roitsch-code/bedroom-air-monitor/firmware/trmnl-display/config.example.h

// Copy this file to config.h and fill in your values. config.h is git-ignored.
#pragma once

// ── Wi-Fi ────────────────────────────────────────────────────────────────────
#define WIFI_SSID   "your-network"
#define WIFI_PASS   "your-password"

// ── Where to fetch the reading from ──────────────────────────────────────────
// The sensor node's /now endpoint. Use the sensor's FIXED IP.
#define SENSOR_URL  "http://192.168.1.50/now"

// ── Outdoor temperature (Open-Meteo, no key needed) ─────────────────────────
// Your rough coordinates — this is only used for the outdoor reading, nothing else.
#define WEATHER_LAT  "51.2277"
#define WEATHER_LON  "6.7735"

// ── Refresh cadence ──────────────────────────────────────────────────────────
// How long between redraws. Every wake costs a Wi-Fi connect + a full e-ink flash, so don't go
// too low — 10–15 minutes is plenty for air.
#define REFRESH_MINUTES  12

// ── Airing verdict — PLACEHOLDER thresholds ──────────────────────────────────
// Markus is designing the real decision (CO₂ + VOC + indoor/outdoor temp + humidity together)
// himself — this is only a stand-in so the display shows something sensible until that's ready.
// Swap the numbers here, or replace decideAiring() in the .ino once the real rules exist.
#define CO2_AIR_PPM      1400   // at/above this: window should go, full stop
#define CO2_SOFT_PPM     1000   // between SOFT and AIR: worth a quick airing
#define VOC_AIR          250    // Sensirion VOC index (~100 = normal air): treated as seriously as high CO₂
#define VOC_SOFT         150    // between SOFT and AIR: worth a quick airing, same as CO₂_SOFT
#define HUMIDITY_HIGH    60     // %RH at/above this: airing hint mentions it regardless of CO₂/VOC
// How much drier outside must be than inside, in ABSOLUTE humidity (grams of water per m³ — NOT
// %RH), before airing is actually recommended for humidity. Absolute humidity is what physically
// matters: warm air holds far more water than cold air, so "90% outside" at 3°C can hold LESS real
// water than "60% inside" at 22°C — comparing %RH directly gets that backwards. Without this: a
// rainy mild day (outdoor RH ~100%, similar temp to indoors) would wrongly say "air it out" and
// make the room damper; a cold winter day (outdoor RH also ~90%, but freezing) would wrongly say
// "don't bother" even though that cold air is exactly what would dry the room out.
#define HUMIDITY_MARGIN_ABS  1.5   // g/m³ outside must be below inside
// Below this outdoor temperature, an airing recommendation is phrased as a short burst
// (Stoßlüften) rather than leaving the window open — cold air drops the room's temperature fast.
#define COLD_OUTSIDE_C   5
