roitsch-code/bedroom-air-monitor/(commit log)

2026-08-24 Seed the project: two firmwares, wiring, and a README worth reading
    The sensor node (QT Py ESP32-S2) reads the SCD-41 and SEN54 over one solderless
    I2C chain, serves the current reading as JSON on the LAN, and optionally logs it.
    The SCD-41 runs continuously because it is silent; the SEN54's fan only spins up
    in short bursts so it does not hum next to where you sleep.
    The display node (TRMNL / XIAO ESP32-S3) fetches that JSON on an interval, draws
    CO2, temperature, humidity and a plain airing hint, and deep-sleeps between. No
    TRMNL cloud, no third-party server — the two devices talk straight to each other.
    Honest about what is not yet proven: the firmware follows the named libraries'
    doc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
    [config.example.h, qtpy-sensor.ino, trmnl-display.ino]
2026-08-25 Wiring: spell out the SCD-41's two ports and the SEN54's 6-pin JST-GH cable
    Verified against Adafruit's adapter docs — the SEN54 connects with the 6-pin
    JST-GH cable it ships with, not a STEMMA QT. Noted the keyed connectors and to
    plug USB in last.
    Claude-Session: https://claude.ai/code/session_01WurZF8924VeSZfsHVJGuCe
2026-08-25 Flag the missing cable: SEN54 to adapter needs a JST-GH plug-to-plug, not included
    Neither the adapter nor the SEN54's own cable gives you a usable sensor-to-adapter
    link — the adapter ships bare and the SEN54's cable has bare pins on one end. You
    need a 6-pin JST-GH plug-to-plug cable (e.g. Adafruit 5754), ordered separately.
    The CO2 sensor needs none of this and can be built first.
    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
2026-08-25 Fix Sensirion API: match the current library naming and methods
    The sketch was written against the old Sensirion library API. The libraries in
    the Library Manager now use SensirionI2cScd4x.h (lowercase c) with begin(Wire,
    SCD41_I2C_ADDR_62), setAutomaticSelfCalibrationEnabled and getDataReadyStatus,
    while the SEN5x lib keeps SensirionI2CSen5x.h (uppercase). Compilation failed on
    the first missing header; corrected all four names and the three renamed calls.
    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
    [qtpy-sensor.ino]
2026-08-25 Use Wire1 for the sensors: the QT Py ESP32-S2 STEMMA QT port is not Wire
    Confirmed on real hardware: the sensor powered up (green LED) but never answered
    on I2C, because the code talked on Wire (the castellated side pads) while the
    STEMMA QT connector — where the sensor actually plugs in — is Wire1 (SDA1/SCL1)
    on this board. Set the pins explicitly and begin Wire1. Also added the 500 ms
    the SCD4x needs after stopPeriodicMeasurement before it will start, without
    which the CO2 reading never becomes ready.
    Verified live: CO2 reads ~540 ppm at rest and jumps past 1400 on a breath.
    Claude-Session: https://claude.ai/code/session_01WurZF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
2026-08-26 Fix firmware to match Seeed's actual Seeed_GFX library
    Verified against the library source and Seeed's own wiki
    (wiki.seeedstudio.com/ogdiy_kit_works_with_arduino): the real header
    is TFT_eSPI.h (Seeed_GFX is a TFT_eSPI fork that kept the name), and
    driver.h needs BOTH BOARD_SCREEN_COMBO 502 AND
    USE_XIAO_EPAPER_DISPLAY_BOARD_EE04 (the second one selects the pin
    map for this exact carrier board, confirmed against
    EPaper_Board_Pins_Setups.h) -- my first pass had the wrong include
    name and had dropped the second define.
    [driver.h, trmnl-display.ino]
2026-08-26 Fix: move Verdict struct above Reading's function block
    Arduino auto-generates function prototypes near the top of the file;
    a prototype returning Verdict before the struct was defined further
    down failed with 'Verdict does not name a type'.
    [trmnl-display.ino]
2026-08-27 Add first rough enclosure concept (OpenSCAD)
    Three-bay case: QT Py (USB-C exit), SCD-41 (5 vent slots), SEN54
    module (7 vent slots + side fan hole) -- verified against Adafruit's
    and Sensirion's own published dimensions. Rendered and STL-exported
    locally to catch two real bugs before handing it over: a 2D/3D module
    mixup that dropped the walls entirely, and screw bosses that were
    getting deleted by the interior cavity cut.
    [sensor-case.scad]
2026-08-27 Reserve real space for the SEN5x adapter board, drop the wrong cable-exit hole
    Markus measured the adapter board (25.4 x 20.0 x 5.0mm) -- it now has
    its own open-sided nest at the far end of the SEN54 bay, sized to the
    real footprint. Removed the JST-GH wall cutout: that cable only runs
    between the module and the adapter, both inside the same bay, so it
    never needs to leave the case.
    Also bumped the tail-length estimate to fit both the module's own
    connector tab and the adapter board.
    Caught and noted a render gotcha while verifying: openscad -o file.png
    without --render can draw a small nested difference() as a solid
    block even when the real geometry (confirmed via --render and via STL
    ex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
    [sensor-case.scad]
2026-08-28 Add PM2.5 and VOC from the SEN54 to the display
    Footer grows from 4 to 6 evenly-split columns: CO2/INNEN/DRAUSSEN/
    FEUCHTE stay, FEINSTAUB (PM2.5) and VOC join from the sensor's /now
    JSON. Both show -- until the SEN54's intermittent fan burst has
    sampled at least once -- same honest-placeholder pattern as every
    other missing reading, not a fabricated 0.
    [trmnl-display.ino]
2026-08-28 Sub-text was still too small next to the headline -- double its size
    26px next to a 52px headline read as tiny on the real device. Now
    drawn at the same 2x scale (52px) as the headline. wrapText() now
    takes the text size it should measure at, so line-wrapping matches
    what actually gets drawn instead of wrapping too generously. Box
    grew from 208 to 248px tall to fit two lines at the bigger size.
    [trmnl-display.ino]
2026-08-28 Smarter airing verdict: absolute humidity, VOC, uppercase design
    Compare indoor/outdoor humidity in absolute terms (g/m3, Magnus-Tetens)
    instead of raw %RH. A rainy day at 100% RH outside really is wetter
    than the room and airing should wait; a cold winter day at 90% RH
    outside is actually drier once warmed indoors, so airing should still
    be recommended -- a plain %RH comparison gets the second case backwards.
    VOC now feeds the verdict as its own trigger (soft/high thresholds,
    same tiers as CO2) instead of only appearing in the footer. A cold
    outside temperature adds a "short burst" (Stosslueften) hint instead
    of implying the window should stay open.
    Also applies the approved design: upper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
    [config.example.h, trmnl-display.ino]
2026-08-28 Fix verdict text overflowing the 3-line box, mid-sentence
    The longer sentences added for the smarter airing logic (absolute
    humidity, VOC) ran past what 3 lines at this font scale can hold --
    on the real display it just stopped mid-word with no sign it was cut
    (caught on-device: "...genauso feucht oder" then nothing).
    wrapText() now appends "..." when text doesn't fit instead of
    silently dropping the rest, as a backstop. The actual fix is that
    every decideAiring() sentence is now much shorter (worst case ~75
    chars total, was over 120 in the humid/rain case), well inside what
    3 lines actually fit.
    [trmnl-display.ino]
2026-08-28 Fix VOC stuck at 0: persist the algorithm state across bursts
    In intermittent mode the SEN54's fan (and its measurement mode) is
    stopped after every single burst. Sensirion's own library docs confirm
    that stopping and restarting measurement resets the on-chip VOC index
    algorithm to its initial state every time -- so with a single ~30s
    sample per burst, the index never left its "still learning" phase,
    which reports 0.
    Fix: save the algorithm's state (getVocAlgorithmState) right before
    stopping each burst, and restore it (setVocAlgorithmState) right
    before starting the next one. State lives in RAM across bursts within
    the same power-on session; a reboot still relearns from scratch, same
    as da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
    [qtpy-sensor.ino]
2026-08-28 Log VOC algorithm state save/restore success instead of ignoring it
    Both calls returned an error code we were discarding -- a failed
    restore would look identical to "the algorithm is still learning"
    from the outside (both show voc staying at 0), so there was no way to
    tell them apart. Now logged over Serial, and a failed save no longer
    marks the state as valid to restore next time.
    [qtpy-sensor.ino]
2026-08-28 Fix VOC=0 properly: keep gas sensor alive in RHT/Gas-Only mode
    Root cause, confirmed against Sensirion's "Reduced Power Operation for
    SEN5x" app note: intermittent mode was dropping the sensor to Idle
    between bursts (stopMeasurement), which powers the VOC gas sensor OFF.
    The VOC Index algorithm adapts over hours, so a sensor that is fully
    powered down every 15 minutes never leaves its initial state -- it
    reports 0 forever. Saving/restoring the algorithm state was a band-aid
    on the wrong end (and per the library docs it only applies once anyway).
    Correct design (Sensirion's own): only duty-cycle the FAN, never the
    gas sensor. Between dust bursts the sensor now sits in RHT/Gas-Only
    mode via s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
    [qtpy-sensor.ino]
2026-08-28 Verdict card: light-grey box for calm states, black box only for action
    Matches Markus's mockups exactly. The black inverted box is an alert
    treatment and only belongs on action verdicts ("Fenster auf", "Bald
    lueften"). Calm / nothing-to-do verdicts ("Alles gut", the "warten"
    states, "Keine Daten") were also getting the black box, which read as
    a false alarm.
    Now a Verdict carries an `action` flag: true -> black box, white text;
    false -> light-grey box, black text. The panel is pure black/white, so
    the light grey is a sparse 3x3 dither that reads as grey from viewing
    distance. Box text is drawn transparent so the letters sit on the grey
    instead of punching white cells into the dither.
    [trmnl-display.ino]
2026-08-28 Add case-design handover for the next session
    Electronics are done (display + sensor firmware verified, VOC fixed and
    confirmed at 99). What's left is two 3D-printable enclosures. Priority
    per Markus: (1) TRMNL display case -- much more important, does not
    exist yet; (2) sensor case -- first draft exists, needs rework.
    Captures the physical facts known this session (part names, the battery
    label, the sensor dims already in sensor-case.scad), and -- honestly --
    flags exactly which dimensions must be measured or looked up before
    designing the TRMNL case rather than guessed, plus the open design
    questions to put to Markus first.
2026-08-28 Move case handover to repo root as HANDOVER.md
2026-08-29 Log to HealthSync + make the bedside screen time-aware
    Sensor (qtpy-sensor): enable the optional logging POST to a server.
    - HTTPS support: WiFiClientSecure at FUNCTION scope (a block-scoped client was
    destroyed before http.POST(), so the body was lost and the server rejected an
    empty request). Plain http:// still works for a LAN relay.
    - First post fires ~5s after warmup, then every POST_MINUTES, so you see whether
    logging works without waiting five blind minutes after an upload.
    - Boot prints the logging target (or "OFF") for quick diagnosis.
    Display (trmnl-display): the airing verdict is now TIME-AWARE and rotating.
    - Framed by time of day (morning / day / evening / night) — a 07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
